jpfranca-br/thermostat/pics/pic1.jpg

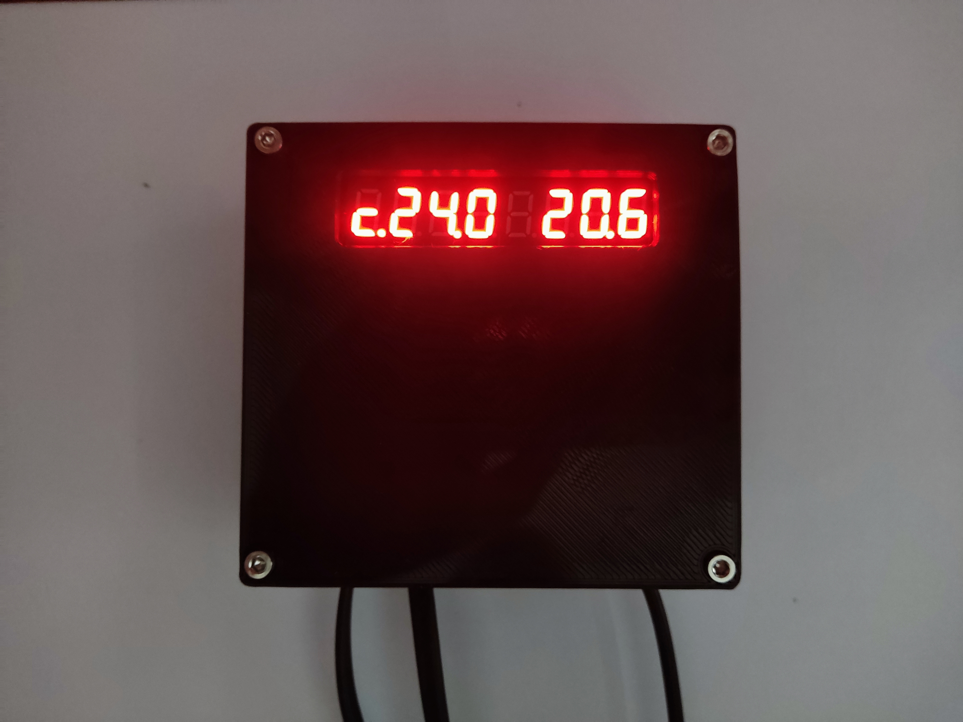
pics/pic1.jpg
