jpfranca-br/thermostat/pics/pic2.jpg

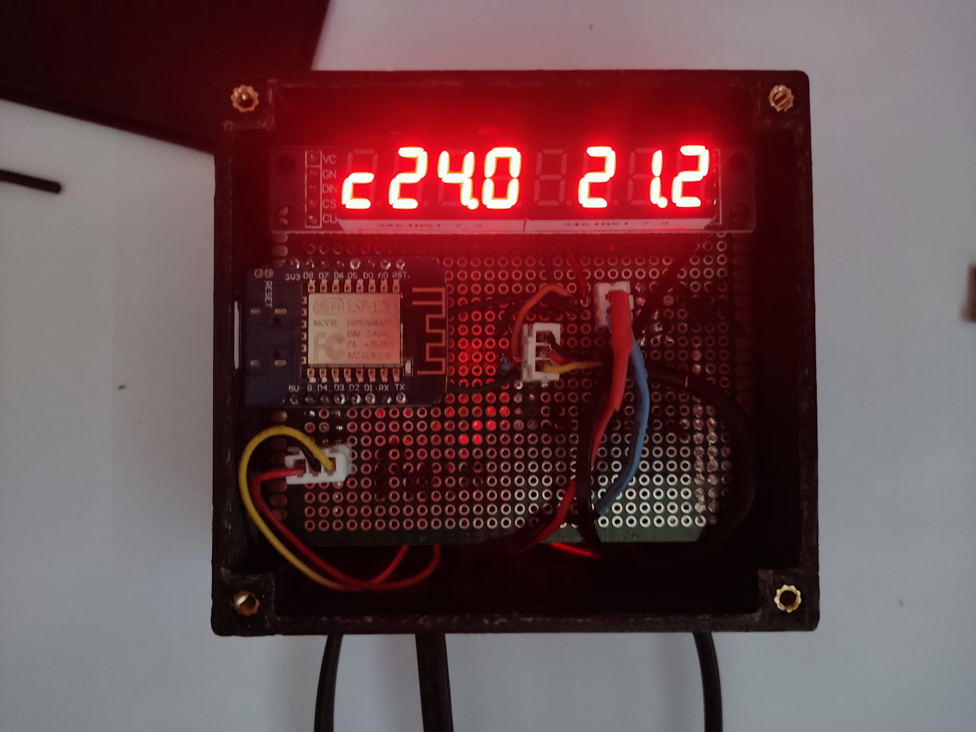
pics/pic2.jpg
