jpfranca-br/thermostat/pics/pic3.jpg

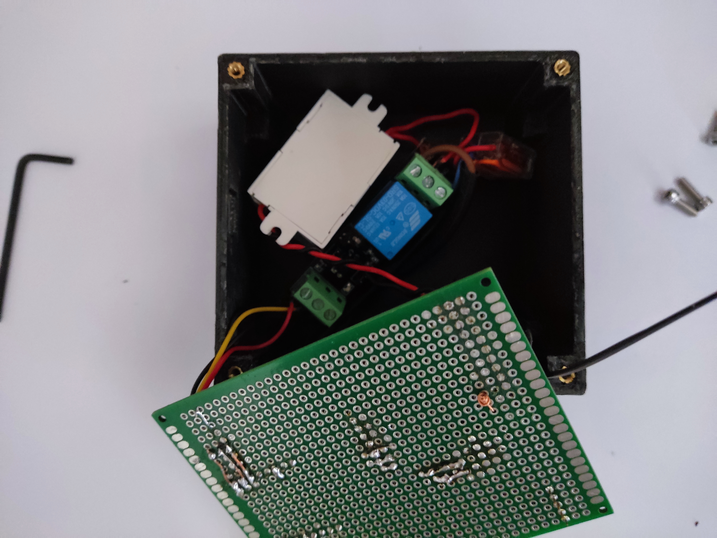
pics/pic3.jpg
