jpfranca-br/thermostat/pics/pic4.jpg

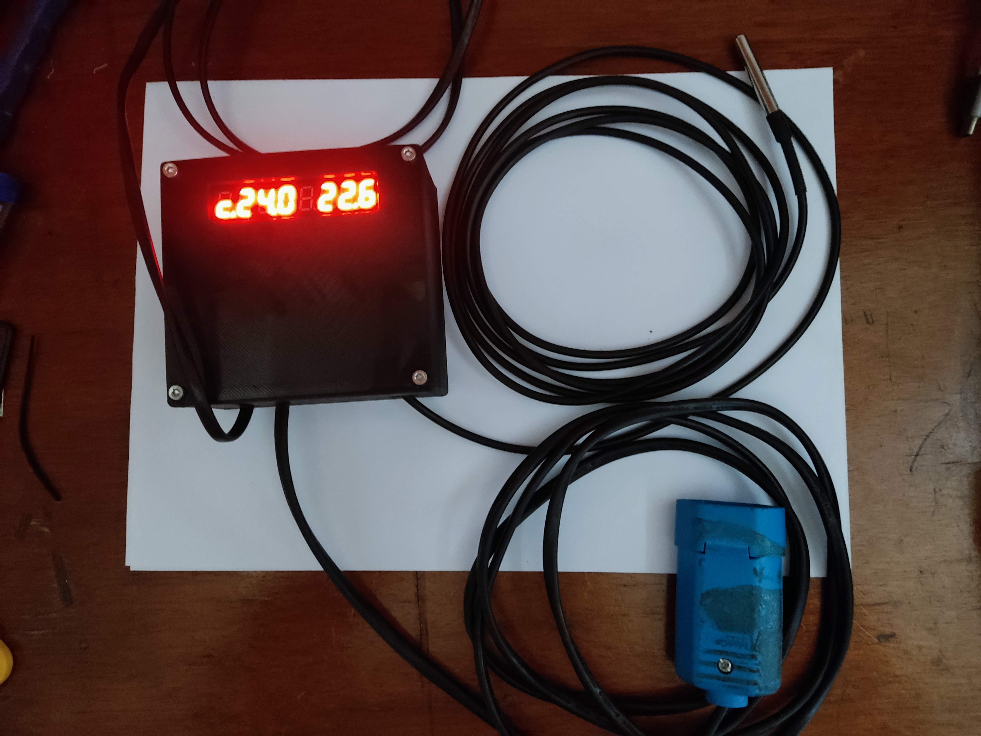
pics/pic4.jpg
